cropinghigh/CBModem/hardware/communicator_27mhz.kicad_pcb

## KiCad design hardware/communicator_27mhz.kicad_pcb (2023-03-02)

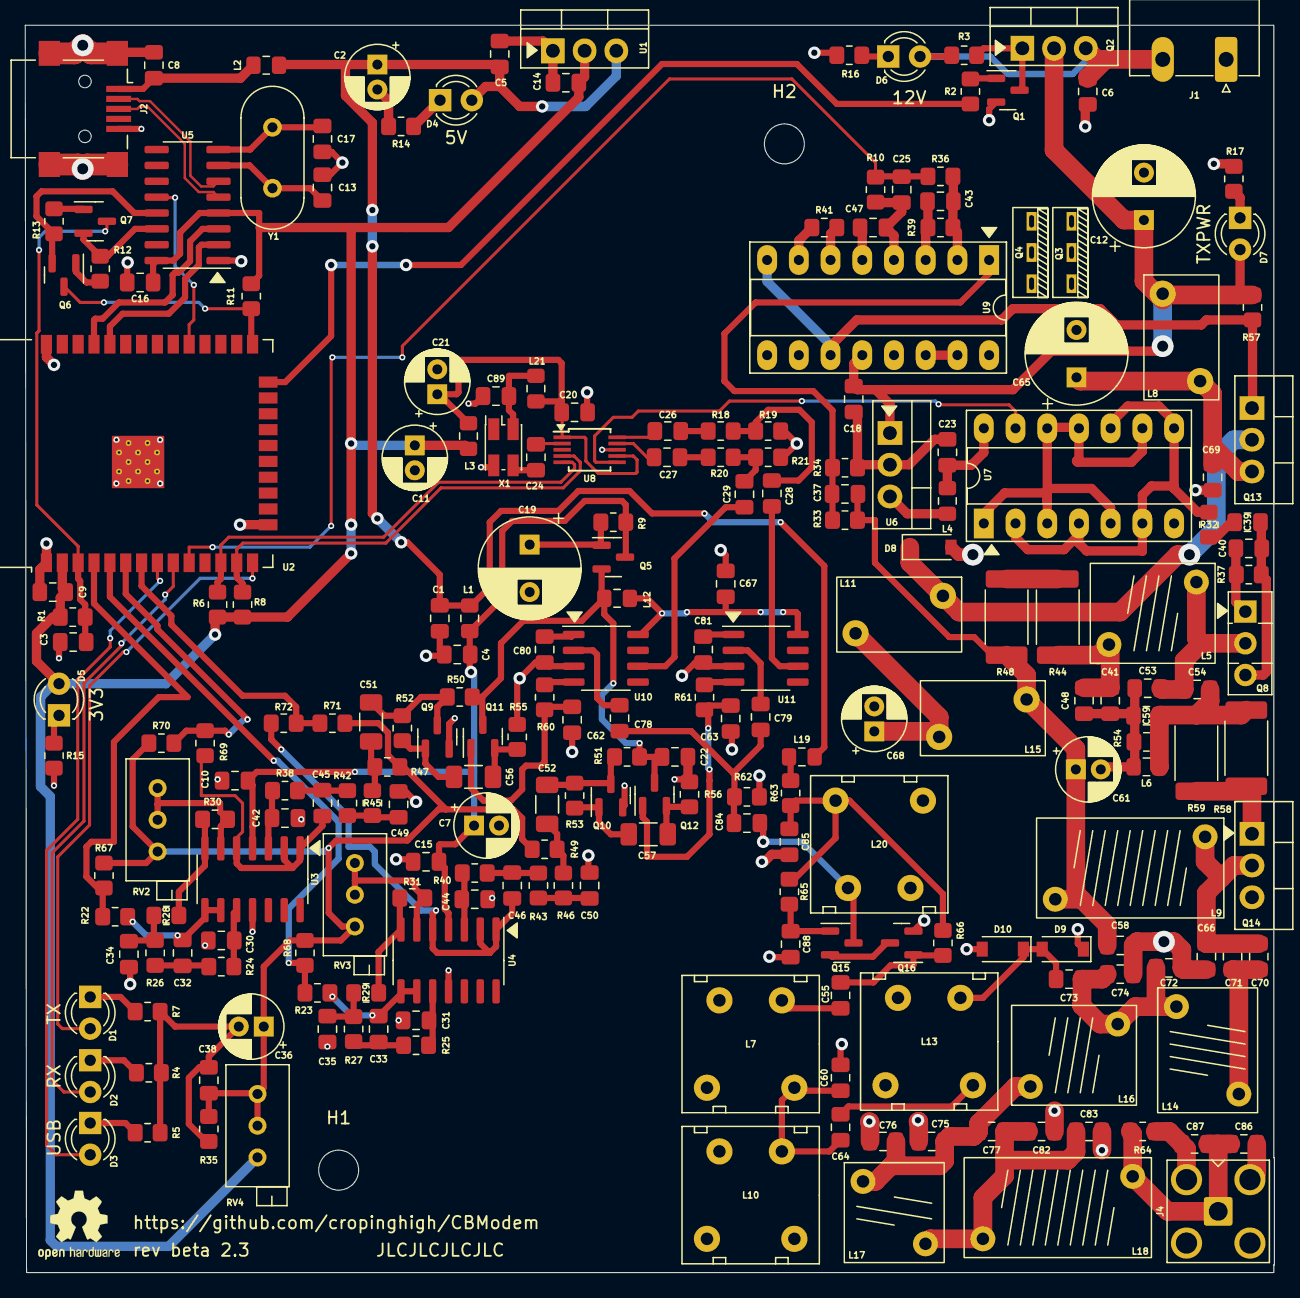
[picture p1: board communicator_27mhz.kicad_pcb from above]

Board: 2 copper layers, 100.0 x 99.9 mm, 230 parts (0 on the bottom side), 132 nets.

Parts:
C1, C4, C5, C6, C8, C9, C10, C14, C15, C16, C18, C20, C23, C24, C26, C27, C28, C29, C38, C39, C43, C54, C58, C67, C69, C85, C89: 0.1u; C_0805_2012Metric_Pad1.18x1.45mm_HandSolder
C3: 2.2u; C_0805_2012Metric_Pad1.18x1.45mm_HandSolder
C7, C21, C36: 47u; CP_Radial_D5.0mm_P2.00mm
C11: 10u; CP_Radial_D5.0mm_P2.00mm
C12, C19: 470u; CP_Radial_D8.0mm_P3.80mm
C13, C17: 22p; C_0805_2012Metric_Pad1.18x1.45mm_HandSolder
C25, C32, C33, C34, C35, C45, C46, C49, C50, C62, C63, C78, C79, C80, C81, C88: 10n; C_0805_2012Metric_Pad1.18x1.45mm_HandSolder
C30, C31, C42, C44, C47: 1n; C_0805_2012Metric_Pad1.18x1.45mm_HandSolder
C37: 6n8; C_0805_2012Metric_Pad1.18x1.45mm_HandSolder
C40, C86: 150p; C_0805_2012Metric_Pad1.18x1.45mm_HandSolder
C41, C48: 47n; C_0805_2012Metric_Pad1.18x1.45mm_HandSolder
C51, C52, C56, C57: 10u; C_1206_3216Metric_Pad1.33x1.80mm_HandSolder
C53, C60, C72, C74, C75: 330p; C_0805_2012Metric_Pad1.18x1.45mm_HandSolder
C55, C64: 470p; C_0805_2012Metric_Pad1.18x1.45mm_HandSolder
C59, C66: 100p; C_0805_2012Metric_Pad1.18x1.45mm_HandSolder
C70, C71, C76, C82, C83: 220p; C_0805_2012Metric_Pad1.18x1.45mm_HandSolder
C73, C84: 47p; C_0805_2012Metric_Pad1.18x1.45mm_HandSolder
C77: 39p; C_0805_2012Metric_Pad1.18x1.45mm_HandSolder
C87: 30p; C_0805_2012Metric_Pad1.18x1.45mm_HandSolder
C?: 22u; CP_Radial_D8.0mm_P3.80mm
C?#2: 47u; CP_Radial_D5.0mm_P2.00mm
C?#3: 0.1u; C_0805_2012Metric_Pad1.18x1.45mm_HandSolder
C?#4, C?#5: 22u; CP_Radial_D5.0mm_P2.00mm
D1: TX; LED_D3.0mm
D2: RX; LED_D3.0mm
D3: USB; LED_D3.0mm
D4: 5V; LED_D3.0mm
D5: 3V3; LED_D3.0mm
D6: 12V; LED_D3.0mm
D7: TXPWR; LED_D3.0mm
D8, D9, D10: 4148; D_SOD-123
H1, H2: M3; MountingHole_3.2mm_M3
J1: EXT_12V; PhoenixContact_MC_1,5_2-G-5.08_1x02_P5.08mm_Horizontal
J2: USB_B_Micro; USB_Mini-B_Lumberg_2486_01_Horizontal
J4: ANT; SMA_Amphenol_901-143_Horizontal
L1, L2, L3, L4, L12, L19, L21: 10uH; L_0805_2012Metric_Pad1.15x1.40mm_HandSolder
L5: 0.15uH(6T,d6); Inductor_10x8
L6: 6.8uH; L_0805_2012Metric_Pad1.15x1.40mm_HandSolder
L7, L10: 220n; Soviet_inductor_core_vertical
L8, L15: ~40T on М2000НМ core; Ferrite_ring_10x6x5_vertical
L9: 0.5uH(13T,d5); Inductor_15x8
L11: 6T on М2000НМ core; Ferrite_ring_10x6x5_vertical
L13: 820n; Soviet_inductor_core_vertical
L14: 0.225uH(6T,d6); Inductor_10x8
L16: 6T, d=5; Inductor_10x8
L17: 7T, d=4; Inductor_8x8
L18: 10T, d=4mm; Inductor_15x8
L20: 3.7-20uH; Soviet_inductor_core_vertical
LOGO1: Logo_Open_Hardware_Large; OSHW-Logo2_7.3x6mm_SilkScreen
Q1: MMBT2222A; SOT-23
Q2, Q13: IRF9Z34N; TO-220-3_Vertical
Q3, Q4: KT315; KT-13
Q8: C2314; TO-126-3_Vertical
Q14: C2078; TO-220-3_Vertical
Q?: MMBT2222A; SOT-23
Q?#2, Q?#3, Q?#4, Q?#5, Q?#6, Q?#7, Q?#8, Q?#9: MMBT2222A; SOT-23
R1, R3, R11, R12, R13, R22, R23, R26, R27, R42, R43, R67, R68, R69, R70, R71, R72: 10k; R_0805_2012Metric_Pad1.20x1.40mm_HandSolder
R2: 50k; R_0805_2012Metric_Pad1.20x1.40mm_HandSolder
R4, R5, R6, R7, R8, R15: 1k; R_0805_2012Metric_Pad1.20x1.40mm_HandSolder
R9, R62: 680; R_0805_2012Metric_Pad1.20x1.40mm_HandSolder
R14: 2k; R_0805_2012Metric_Pad1.20x1.40mm_HandSolder
R16, R17, R34, R41, R47, R49, R50, R51: 5k; R_0805_2012Metric_Pad1.20x1.40mm_HandSolder
R18, R20: 6k8; R_0805_2012Metric_Pad1.20x1.40mm_HandSolder
R19, R21: 510; R_0805_2012Metric_Pad1.20x1.40mm_HandSolder
R24, R25, R38, R40: 5k6; R_0805_2012Metric_Pad1.20x1.40mm_HandSolder
R28, R29, R45, R46, R60, R61: 3k3; R_0805_2012Metric_Pad1.20x1.40mm_HandSolder
R30, R31: 20k; R_0805_2012Metric_Pad1.20x1.40mm_HandSolder
R32: 10; R_0805_2012Metric_Pad1.20x1.40mm_HandSolder
R35: 500; R_0805_2012Metric_Pad1.20x1.40mm_HandSolder
R36: 470; R_0805_2012Metric_Pad1.20x1.40mm_HandSolder
R37, R63: 100; R_0805_2012Metric_Pad1.20x1.40mm_HandSolder
R39, R52, R53: 100k; R_0805_2012Metric_Pad1.20x1.40mm_HandSolder
R44, R48, R58, R59: 5 1W; R_2512_6332Metric_Pad1.40x3.35mm_HandSolder
R54: 150; R_0805_2012Metric_Pad1.20x1.40mm_HandSolder
R55, R56: 900; R_0805_2012Metric_Pad1.20x1.40mm_HandSolder
R57: 330; R_0805_2012Metric_Pad1.20x1.40mm_HandSolder
R64: 4k7; R_0805_2012Metric_Pad1.20x1.40mm_HandSolder
R65, R66: 25k; R_0805_2012Metric_Pad1.20x1.40mm_HandSolder
R?: 20k; R_0805_2012Metric_Pad1.20x1.40mm_HandSolder
R?#2: 20k; R_0805_2012Metric_Pad1.20x1.40mm_HandSolder
RV2, RV3: 10k; Potentiometer_Bourns_3296X_Horizontal
RV?: 100k; Potentiometer_Bourns_3296X_Horizontal
U1: LM1117-3.3; TO-220-3_Vertical
U2: ESP32-WROOM-32
U3, U4: LM324; SOIC-14_3.9x8.7mm_P1.27mm
U5: CH340G; SOIC-16_3.9x9.9mm_P1.27mm
U6: L7805; TO-220-3_Vertical
U7: 74ACT14; DIP-14_W7.62mm_Socket_LongPads
U8: Si5351A; MSOP-10_3x3mm_P0.5mm
U9: TL494; DIP-16_W7.62mm_Socket_LongPads
U10, U11: SA612; SO-8_3.9x4.9mm_P1.27mm
X1: 3225 25 MHz TCXO; Oscillator_SMD_EuroQuartz_XO32-4Pin_3.2x2.5mm_HandSoldering
Y1: 12M; Crystal_HC49-4H_Vertical

Connections:
+3V3: C9.1, C11.1, C14.1, C16.2, D5.2 (A), L3.1, R1.1, R6.2, R8.2, R11.2, RV?.3, U1.2 (VO), U2.2 (VDD), U5.4 (V3), U5.16 (VCC)
+3V3FILT: C20.2, C21.1, L3.2, L21.2, U8.1 (VDD), U8.7 (VDDO)
+5V: C1.1, C5.1, C?#2.1, D4.2 (A), L1.1, L2.2, L19.2, U1.3 (VI)
+5VFILT: C4.1, C7.1, C10.1, C15.1, L1.2, Q?#3.3 (C), R9.1, U3.4 (V+), U4.4 (V+)
+5VMXR: C?#3.2, L12.1, Q?.3 (C), Q?#3.2 (E), Q?#8.3 (C), R50.1, R51.1
+5VTX: L4.1, U6.3 (OUT)
+12V: C6.1, D6.2 (A), J1.2, Q2.3 (S), R3.1
+12VTX: C12.1, C18.1, D7.2 (A), L8.2, Q2.2 (D), R57.1, U6.1 (IN), U9.12 (VCC)
/CLK_I: C27.1, U8.9 (CLK1)
/CLK_Q: C26.1, U8.10 (CLK0)
/RX_ANT_CLAMPED: C73.2, D9.2 (A), D10.1 (K), L13.2
/SCL: R8.1, U2.13 (IO14), U8.4 (SCL)
/SDA: R6.1, U2.12 (IO27), U8.5 (SDA)
/UD+: J2.3 (D+), U5.5 (UD+)
/UD-: J2.2 (D-), U5.6 (UD-)
ADCIN_I: R22.1, R67.2, U2.4 (SENSOR_VP)
ADCIN_LOW_I: R69.1, R70.2, U2.6 (IO34)
ADCIN_LOW_Q: R71.1, R72.2, U2.7 (IO35)
ADCIN_Q: R23.1, R68.1, U2.5 (SENSOR_VN)
GND: C1.2, C3.2, C4.2, C5.2, C6.2, C7.2, C8.2, C9.2, C10.2, C11.2, C12.2, C13.2, C14.2, C15.2, C16.1, C17.2, C18.2, C19.2, C20.1, C21.2, C23.2, C25.2, C30.2, C31.2, C34.2, C35.2, C36.2, C38.2, C40.1, C41.2, C42.2, C44.2, C47.1, C48.2, C49.2, C50.2, C53.2, C58.2, C59.2, C60.2, C62.2, C63.2, C66.2, C67.2, C69.2, C72.2, C74.2, C75.2, C76.2, C80.2, C81.2, C82.2, C83.2, C85.2, C86.2, C87.2, C88.1, C89.2, C?.2, C?#2.2, C?#3.1, C?#4.2, C?#5.2, D8.2 (A), D9.1 (K), D10.2 (A), J1.1, J2.5 (GND), J2.6 (Shield), J4.2 (Ext), L6.2, L10.1, Q1.2 (E), Q3.1 (B), Q3.2 (C), Q3.3 (E), Q4.1 (B), Q4.2 (C), Q4.3 (E), Q8.1 (E), Q14.3 (E), Q?#4.2 (E), Q?#6.2 (E), Q?#9.2 (E), R4.2, R5.1, R7.2, R14.2, R15.2, R16.2, R17.2, R19.1, R21.1, R34.2, R35.2, R37.2, R41.2, R54.2, R55.2, R56.2, R62.2, R64.2, R?.1, U1.1 (GND), U2.1 (GND), U2.15 (GND), U2.38 (GND), U2.39 (GND), U3.11 (V-), U4.11 (V-), U5.1 (GND), U6.2 (GND), U7.7 (GND), U8.8 (GND), U9.4 (DTC), U9.7 (GND), U9.9 (E1), U9.10 (E2), U9.13 (OUTCTRL), U9.16 (2IN+), U10.3 (GND), U11.3 (GND), X1.2 (GND)
LO_RX_I: C29.2, U10.6 (OSC_B)
LO_RX_Q: C28.1, U11.6 (OSC_B)
LO_TX: U7.13, U8.6 (CLK2)
MCU_DCD: U2.29 (IO5), U5.12 (~DCD)
MCU_EN: C3.1, Q?#7.3 (C), R1.2, U2.3 (EN)
MCU_G0: Q?#2.3 (C), R11.1, U2.25 (IO0)
MCU_RXD: U2.34 (RXD0/IO3), U5.2 (TXD)
MCU_TXD: U2.35 (TXD0/IO1), U5.3 (RXD)
unnamed: C8.1, J2.1 (VBUS), L2.1
unnamed: C13.1, U5.7 (XI), Y1.1
unnamed: C17.1, U5.8 (XO), Y1.2
unnamed: C19.1, Q?#3.1 (B), R9.2
unnamed: C23.1, L4.2, U7.14 (VCC)
unnamed: C24.1, X1.3 (OUT)
unnamed: C24.2, U8.2 (XA)
unnamed: C26.2, R18.2
unnamed: C27.2, R20.2
unnamed: C28.2, R18.1, R19.2
unnamed: C29.1, R20.1, R21.2
unnamed: C30.1, R24.2, U3.10 (+)
unnamed: C31.1, R25.2, U4.10 (+)
unnamed: C32.1, R24.1, R26.2
unnamed: C32.2, R22.2, U3.8, U3.9 (-)
unnamed: C33.1, R25.1, R27.2
unnamed: C33.2, R23.2, U4.8, U4.9 (-)
unnamed: C34.1, R26.1, R28.2
unnamed: C35.1, R27.1, R29.2
unnamed: C37.1, C58.1, C?#4.1, L9.1, L15.2, R48.2, R?#2.1
unnamed: C37.2, R34.1, R?#2.2, U9.1 (1IN+)
unnamed: C39.1, R32.2
unnamed: C39.2, C40.2, Q8.3 (B), R37.1
unnamed: C41.1, C48.1, L5.1, R44.1
unnamed: C42.1, R38.2, U3.3 (+)
unnamed: C43.1, R36.2, R39.2, U9.2 (1IN-)
unnamed: C43.2, R39.1, U9.3 (FB)
unnamed: C44.1, R40.2, U4.3 (+)
unnamed: C45.1, R38.1, R42.2
unnamed: C45.2, R69.2, U3.1, U3.2 (-), U3.5 (+)
unnamed: C46.1, R40.1, R43.2
unnamed: C46.2, R72.1, U4.1, U4.2 (-), U4.5 (+)
unnamed: C47.2, U9.5 (CT)
unnamed: C49.1, R42.1, R45.2
unnamed: C50.1, R43.1, R46.2
unnamed: C51.1, Q?#6.3 (C), R50.2, R52.1
unnamed: C51.2, R45.1, R47.1
unnamed: C52.1, Q?#4.3 (C), R51.2, R53.1
unnamed: C52.2, R46.1, R49.1
unnamed: C53.1, C54.2, L5.2, Q8.2 (C)
unnamed: C54.1, C59.1, L6.1, R54.1, R58.2, R59.1
unnamed: C55.2, L7.2
unnamed: C56.1, Q?.2 (E), R55.1
unnamed: C56.2, Q?#6.1 (B), R52.2
unnamed: C57.1, Q?#8.2 (E), R56.1
unnamed: C57.2, Q?#4.1 (B), R53.2
unnamed: C60.1, C64.1, L7.1, L10.2
unnamed: C62.1, Q?.1 (B), R60.2
unnamed: C63.1, Q?#8.1 (B), R61.2
unnamed: C64.2, L13.1
unnamed: C69.1, C?.1, L8.1, Q13.3 (S)
unnamed: C66.1, C70.2, C71.2, L9.2, Q14.2 (C)
unnamed: C67.1, L12.2, U10.8 (VCC), U11.8 (VCC)
unnamed: C?#5.1, L11.1, L15.1
unnamed: C70.1, C71.1, L14.1
unnamed: C72.1, C73.1, C74.1, L14.2, L16.1
unnamed: C75.1, C76.1, C77.1, L16.2, L17.2
unnamed: C77.2, C82.1, C83.1, L17.1, L18.1
unnamed: C78.1, C79.1, C84.2, R62.1
unnamed: C78.2, U10.2 (IN_B)
unnamed: C79.2, U11.2 (IN_B)
unnamed: C80.1, U10.1 (IN_A)
unnamed: C81.1, U11.1 (IN_A)
unnamed: C84.1, L20.2, Q?#5.3 (C)
unnamed: C85.1, L20.1, R63.2, R65.1, R66.1
unnamed: C86.1, C87.1, J4.1 (In), L18.2, R64.1
unnamed: C88.2, Q?#5.1 (B), R65.2
unnamed: C89.1, L21.1, X1.4 (Vcc)
unnamed: D1.1 (K), R7.1
unnamed: D1.2 (A), U2.14 (IO12)
unnamed: D2.1 (K), R4.1
unnamed: D2.2 (A), U2.9 (IO33)
unnamed: D3.1 (K), R5.2
unnamed: D3.2 (A), U2.8 (IO32)
unnamed: D4.1 (K), R14.1
unnamed: D5.1 (K), R15.1
unnamed: D6.1 (K), R16.1
unnamed: D7.1 (K), R17.1
unnamed: D8.1 (K), L11.2, Q13.2 (D)
unnamed: L19.1, R63.1
unnamed: Q1.1 (B), R2.1
unnamed: Q1.3 (C), Q2.1 (G), R3.2
unnamed: Q?#2.1 (B), R12.2
unnamed: Q?#2.2 (E), R13.1, U5.13 (~DTR)
unnamed: Q?#7.1 (B), R13.2
unnamed: Q?#7.2 (E), R12.1, U5.14 (~RTS)
unnamed: Q13.1 (G), R57.2, U9.8 (C1), U9.11 (C2)
unnamed: Q14.1 (B), R58.1, R59.2
unnamed: Q?#5.2 (E), Q?#9.3 (C)
unnamed: R28.1, R30.1, U3.7
unnamed: R29.1, R31.1, U4.7
unnamed: R30.2, RV2.1, RV2.2, U3.6 (-)
unnamed: R31.2, RV3.1, RV3.2, U4.6 (-)
unnamed: R32.1, U7.2, U7.4, U7.6, U7.8, U7.10
unnamed: R41.1, U9.6 (RT)
unnamed: R44.2, R48.1
unnamed: R60.1, U10.4 (OUT_A)
unnamed: R61.1, U11.4 (OUT_A)
unnamed: U7.1, U7.3, U7.5, U7.9, U7.11, U7.12
unnamed: U9.14 (REF), U9.15 (2IN-)
RX_AMP_REF_V: C36.1, C38.1, R35.1, R47.2, R49.2, R67.1, R68.2, R70.1, R71.2, RV2.3, RV3.3, RV?.1, RV?.2
RX_IN_ANT: C55.1, Q?#9.1 (B), R66.2
TXAMPL_V: C25.1, R36.1, R?.2, U2.10 (IO25)
TXPENABLE: R2.2, U2.24 (IO2)
