cropinghigh/CBModem/software/esp32/app/components/customdsp/srcs/cdsp_modulator.cpp

#include "cdsp_modulator.h" 

#include "stdio.h"

cdsp_mod_bfsk::cdsp_mod_bfsk(float fs, float fr0, float fr1, float datarate, int taps_cnt) {
    _taps_cnt = taps_cnt;
    _gen = new cdsp_gen_sine_complex(fs, fr0);
    setFs(fs);
    setFrs(fr0, fr1);
    setDataRate(datarate);
    _filt_taps = new float[_taps_cnt];
    float maxfreq = std::max(fabsf(fr0), fabsf(fr1)) + datarate;
    cdsp_calc_taps_lpf_float(_filt_taps, _taps_cnt, fs, maxfreq, true);
    _filt = new cdsp_fir<float, cdsp_complex_t>(_taps_cnt, _filt_taps);
    _filt->setInputFunc(this, filt_requestData);
}

cdsp_mod_bfsk::~cdsp_mod_bfsk() {
    delete[] _filt_taps;
    delete _filt;
    delete _gen;
}

void cdsp_mod_bfsk::setFs(float fs) {
    _fs = fs;
    _gen->setFs(_fs);
    if(_fs != 0) {
        _incr = _datarate / _fs;
        // printf("dr %f fs %f incr %f\n", _datarate, _fs, _incr);
    }
}

void cdsp_mod_bfsk::setFrs(float fr0, float fr1) {
    _fr0 = fr0;
    _fr1 = fr1;
}

void cdsp_mod_bfsk::setDataRate(float datarate) {
    _datarate = datarate;
    if(_fs != 0) {
        setFs(_fs);
    }
}

int cdsp_mod_bfsk::requestData(void* ctx, cdsp_complex_t* data, int samples_cnt) {
    cdsp_mod_bfsk* _this = (cdsp_mod_bfsk*) ctx;
    if(!_this->_running) {return -2;}
    // return _this->_filt->requestData(_this->_filt, data, samples_cnt); Works better without FIR
    return _this->filt_requestData(_this, data, samples_cnt);
}

int cdsp_mod_bfsk::filt_requestData(void* ctx, cdsp_complex_t* data, int samples_cnt) {
    cdsp_mod_bfsk* _this = (cdsp_mod_bfsk*) ctx;
    if(!_this->_running || _this->_input_func==NULL || _this->_incr <= 0) { return -2;}
    int ret = 0;
    while(ret < samples_cnt) {
        int remaining_spls = std::min((int)roundf((1.0f / _this->_incr) * (1.0f - _this->_ctr)), samples_cnt-ret);
        // printf("remain %f, want %d, ctr %f, req %d\n", floorf((1.0f / _this->_incr) * (1.0f - _this->_ctr)), samples_cnt-ret, _this->_ctr, remaining_spls);
        int gotmain = _this->_gen->requestData(_this->_gen, &data[ret], remaining_spls);
        if(gotmain <= 0) {return gotmain;}
        ret += gotmain;
        _this->_ctr += gotmain * _this->_incr;
        if(_this->_ctr >= 1.0f || ((1.0f / _this->_incr) * (1.0f - _this->_ctr)) < 1) {
            // printf("%d %d %d %d %f %f\n", remaining_spls, gotmain, samples_cnt, ret, _this->_incr, _this->_ctr);
            if(_this->_preamble_ctr < MOD_PREAMBLE_SIZE) {
                _this->_gen->setFr((_this->_preamble_ctr % 2) ? _this->_fr1 : _this->_fr0);
                _this->_preamble_ctr++;
            } else {
                int got = _this->_input_func(_this->_func_call_ctx, &_this->_curr_data, 1);
                if(got != 1) {return got;}
                if(_this->_curr_data) {
                    _this->_gen->setFr(_this->_fr1);
                } else {
                    _this->_gen->setFr(_this->_fr0);
                }
            }
            _this->_ctr = 0.0f;
        }
    }
    return ret;
}

void cdsp_mod_bfsk::_do_start()  {
    _ctr = 0;
    _preamble_ctr = 0;
    _gen->start(true);
    _filt->start(true);
}

void cdsp_mod_bfsk::_do_stop() {
    _gen->stop(true);
    _filt->stop(true);
}


cdsp_mod_mfsk::cdsp_mod_mfsk(float fs, int frcnt, float* frs, float datarate, int taps_cnt) {
    _taps_cnt = taps_cnt;
    _frcnt = frcnt;
    _gen = new cdsp_gen_sine_complex(fs, frs[0]);
    setFs(fs);
    setFrs(_frcnt, frs);
    setDataRate(datarate);
    _filt_taps = new float[_taps_cnt];
    float maxfr = -100000;
    for(int i = 0; i < frcnt; i++) {
        maxfr = std::max(maxfr, frs[i]);
    }
    float maxfreq = maxfr + datarate;
    cdsp_calc_taps_lpf_float(_filt_taps, _taps_cnt, fs, maxfreq, true);
    _filt = new cdsp_fir<float, cdsp_complex_t>(_taps_cnt, _filt_taps);
    _filt->setInputFunc(this, filt_requestData);
}

cdsp_mod_mfsk::~cdsp_mod_mfsk() {
    delete[] _filt_taps;
    delete[] _frs;
    delete _filt;
    delete _gen;
}

void cdsp_mod_mfsk::setFs(float fs) {
    _fs = fs;
    _gen->setFs(_fs);
    if(_fs != 0) {
        _incr = _datarate / _fs;
    }
}

void cdsp_mod_mfsk::setFrs(int frcnt, float* frs) {
    _frcnt = frcnt;
    _frbits = floorf(log2f(frcnt));
    assert(_frbits < 256 && _frbits >= 1);
    if(_frs != NULL) {
        delete[] _frs;
    }
    _frs = new float[_frcnt];
    for(int i = 0; i < _frcnt; i++) {
        _frs[i] = frs[i];
    }
}

void cdsp_mod_mfsk::setDataRate(float datarate) {
    _datarate = datarate;
    if(_fs != 0) {
        _incr = _datarate / _fs;
    }
}

int cdsp_mod_mfsk::requestData(void* ctx, cdsp_complex_t* data, int samples_cnt) {
    cdsp_mod_mfsk* _this = (cdsp_mod_mfsk*) ctx;
    if(!_this->_running) {return -2;}
    // return _this->_filt->requestData(_this->_filt, data, samples_cnt); Works much better without FIR
    return _this->filt_requestData(_this, data, samples_cnt);
}

int cdsp_mod_mfsk::filt_requestData(void* ctx, cdsp_complex_t* data, int samples_cnt) {
    cdsp_mod_mfsk* _this = (cdsp_mod_mfsk*) ctx;
    if(!_this->_running || _this->_input_func==NULL || _this->_incr <= 0) { return -2;}
    int ret = 0;
    while(ret < samples_cnt) {
        int remaining_spls = std::min((int)roundf((1.0f / _this->_incr) * (1.0f - _this->_ctr)), samples_cnt-ret);
        int gotmain = _this->_gen->requestData(_this->_gen, &data[ret], remaining_spls);
        if(gotmain <= 0) {return gotmain;}
        ret += gotmain;
        _this->_ctr += gotmain * _this->_incr;
        if(_this->_ctr >= 1.0f || ((1.0f / _this->_incr) * (1.0f - _this->_ctr)) < 1) {
            if(_this->_preamble_ctr < MOD_PREAMBLE_SIZE) {
                _this->_gen->setFr((_this->_preamble_ctr % 2) ? _this->_frs[_this->_frcnt-1] : _this->_frs[0]);
                _this->_preamble_ctr++;
            } else {
                int got = _this->_input_func(_this->_func_call_ctx, _this->_curr_data, _this->_frbits);
                if(got <= 0) {return got;}
                uint8_t newfr = 0;
                for(int i = 0; i < got; i++) {
                    newfr |= ((_this->_curr_data[i] & 0b1) << i);
                }
                _this->_gen->setFr(_this->_frs[newfr]);
            }
            _this->_ctr = 0.0f;
        }
    }
    return ret;
}

void cdsp_mod_mfsk::_do_start() {
    _ctr = 0;
    _preamble_ctr = 0;
    _gen->start(true);
    _filt->start(true);
}

void cdsp_mod_mfsk::_do_stop() {
    _gen->stop(true);
    _filt->stop(true);
}

cdsp_mod_msk::cdsp_mod_msk(float fs, float datarate) {
    _gen = new cdsp_gen_sine_complex(fs, datarate/4.0f);
    setFs(fs);
    setDataRate(datarate);
}

cdsp_mod_msk::~cdsp_mod_msk() {
    delete _gen;
}

void cdsp_mod_msk::setFs(float fs) {
    _fs = fs;
    _gen->setFs(_fs);
    if(_fs != 0) {
        _incr = _datarate / _fs;
        // printf("dr %f fs %f incr %f\n", _datarate, _fs, _incr);
    }
}

void cdsp_mod_msk::setDataRate(float datarate) {
    _datarate = datarate;
    if(_fs != 0) {
        setFs(_fs);
    }
}

float cdsp_mod_msk::getDataRate() {
    return _datarate;
}

int cdsp_mod_msk::requestData(void* ctx, cdsp_complex_t* data, int samples_cnt) {
    cdsp_mod_msk* _this = (cdsp_mod_msk*) ctx;
    if(!_this->_running || _this->_input_func==NULL || _this->_incr <= 0) { return -2;}
    int ret = 0;
    while(ret < samples_cnt) {
        int remaining_spls = std::min((int)roundf((1.0f / _this->_incr) * (1.0f - _this->_ctr)), samples_cnt-ret);
        int gotmain = _this->_gen->requestData(_this->_gen, &data[ret], remaining_spls);
        if(gotmain <= 0) {return gotmain;}
        ret += gotmain;
        _this->_ctr += gotmain * _this->_incr;
        if(_this->_ctr >= 1.0f || ((1.0f / _this->_incr) * (1.0f - _this->_ctr)) < 1) {
            if(_this->_preamble_ctr < MOD_PREAMBLE_SIZE) {
                _this->_gen->setFr((_this->_preamble_ctr % 2) ? (_this->_datarate/4.0f) : (-_this->_datarate/4.0f));
                _this->_preamble_ctr++;
            } else {
                int got = _this->_input_func(_this->_func_call_ctx, &_this->_curr_data, 1);
                if(got != 1) {return got;}
                if(_this->_curr_data) {
                    _this->_gen->setFr((_this->_datarate/4.0f));
                } else {
                    _this->_gen->setFr((-_this->_datarate/4.0f));
                }
            }
            _this->_ctr = 0.0f;
        }
    }
    return ret;
}

void cdsp_mod_msk::_do_start() {
    _ctr = 0;
    _preamble_ctr = 0;
    _gen->start(true);
}

void cdsp_mod_msk::_do_stop() {
    _gen->stop(true);
}


cdsp_demod_bfsk::cdsp_demod_bfsk(float fs, float fr0, float fr1, float datarate, float sync_loop_bw, float sync_damping, float sync_relLimit) {
    setFs(fs);
    setFrs(fr0, fr1);
    setDataRate(datarate);
    _filt = new cdsp_fir<float, float>(_taps_cnt, _filt_taps);
    _sync = new cdsp_maximum_likelihood_tr<float>(_incr, sync_loop_bw, sync_damping, sync_relLimit);
    _dcblock = new cdsp_dcblock<float>(1.0f);
    _infilt = new cdsp_fir<float, cdsp_complex_t>(_infilt_taps_cnt, _infilt_taps);
    _sync->setInputBlk(_dcblock, _dcblock->requestData);
    _dcblock->setInputBlk(_filt, _filt->requestData);
    _filt->setInputFunc(this, dcb_requestData);
    _infilt->setInputFunc(this, infilt_requestData);
}

cdsp_demod_bfsk::~cdsp_demod_bfsk() {
    delete _filt;
    delete _dcblock;
    delete _sync;
    delete _infilt;
    delete[] _filt_taps;
    delete[] _infilt_taps;
}

void cdsp_demod_bfsk::setFs(float fs) {
    _fs = fs;
    if(_datarate != 0) {
        _incr = _fs / (_datarate);
        _taps_cnt = (int(roundf(_incr)) % 2) ? roundf(_incr)+1 : roundf(_incr);
        _infilt_taps_cnt = _taps_cnt;
        if(_filt_taps != NULL) {
            delete[] _filt_taps;
        }
        if(_infilt_taps != NULL) {
            delete[] _infilt_taps;
        }
        _filt_taps = new float[_taps_cnt];
        _infilt_taps = new float[_infilt_taps_cnt];
        cdsp_calc_taps_lpf_float(_filt_taps, _taps_cnt, _fs, _datarate*1.0f, true);
        cdsp_calc_taps_lpf_float(_infilt_taps, _infilt_taps_cnt, _fs, (fabsf(_fr0) >= fabsf(_fr1) ? 2*fabsf(_fr0*_fs) : 2*fabsf(_fr1*_fs)) + _datarate, true);
        if(_filt != NULL) {
            _filt->setTaps(_taps_cnt, _filt_taps);
        }
        if(_infilt != NULL) {
            _infilt->setTaps(_infilt_taps_cnt, _infilt_taps);
        }
        if(_sync != NULL) {
            _sync->setInSps(_incr);
        }
    }
}

void cdsp_demod_bfsk::setFrs(float fr0, float fr1) {
    _fr0 = fr0 / _fs;
    _fr1 = fr1 / _fs;
    float high = std::max(fabsf(_fr0), fabsf(_fr1));
    _syncmul = 1.0f/high;
    _syncdiv = high;
    if(_datarate != 0) {
        setFs(_fs);
    }
}

void cdsp_demod_bfsk::setDataRate(float datarate) {
    _datarate = datarate;
    if(_datarate != 0) {
        setFs(_fs);
    }
}

void cdsp_demod_bfsk::setLoopBw(float bw) {
	_sync->setLoopBw(bw);
}

//int x = 0;

int cdsp_demod_bfsk::requestData(void* ctx, uint8_t* data, int samples_cnt) {
    cdsp_demod_bfsk* _this = (cdsp_demod_bfsk*) ctx;
    if(!_this->_running || _this->_incr <= 0) { return -2;}
    int req_samples = std::min(samples_cnt, CDSP_DEF_BUFF_SIZE);
    int got = _this->_sync->requestData(_this->_sync, _this->_out_samples, req_samples);
    if(got <= 0) { return got; }
    for(int i = 0; i < got; i++) {
        float curr_fr = _this->_out_samples[i]*_this->_syncdiv;
        float err0 = _this->_fr0 - curr_fr;
        float err1 = _this->_fr1 - curr_fr;
        float nearerr = fabsf(err1) < fabsf(err0) ? err1 : err0;
        data[i] = fabsf(err1) < fabsf(err0) ? 1 : 0; //Binary slicer
        _this->_avgerr += (nearerr - _this->_avgerr) * 0.05f;
//        x += _this->_incr;
    }
    return got;
}

int cdsp_demod_bfsk::dcb_requestData(void* ctx, float* data, int samples_cnt) {
    cdsp_demod_bfsk* _this = (cdsp_demod_bfsk*) ctx;
    if(!_this->_running || _this->_input_func==NULL || _this->_incr <= 0) {return -2;}
    int req_samples = std::min(samples_cnt, CDSP_DEF_BUFF_SIZE);
//     int got = _this->_input_func(_this->_func_call_ctx, _this->_in_samples, req_samples);
    int got = _this->_infilt->requestData(_this->_infilt, _this->_in_samples, req_samples);
    if(got <= 0) {return got;}
    for(int i = 0; i < got; i++) {
        // printf("%d %f %f\n", x, _this->_in_samples[i].i, _this->_in_samples[i].q);
        // x++;
        float fr_rel = (_this->_in_samples[i]*_this->_prev_spl.conj()).ph() * (1.0f/(2.0f*FL_PI)); //Interesting f/fs detector, stolen from gnuradio quadrature demod; works SIGNIFICANTLY better than coherent multiplication&filtering
        _this->_prev_spl = _this->_in_samples[i];
        float err0 = _this->_fr0 - fr_rel;
        float err1 = _this->_fr1 - fr_rel;
        float nearerr = fabsf(err1) < fabsf(err0) ? 0 : err0;
        data[i] = fr_rel * _this->_syncmul;
    }
    return got;
}

int cdsp_demod_bfsk::infilt_requestData(void* ctx, cdsp_complex_t* data, int samples_cnt) {
    cdsp_demod_bfsk* _this = (cdsp_demod_bfsk*) ctx;
    if(!_this->_running || _this->_input_func==NULL || _this->_incr <= 0) {return -2;}
    return _this->_input_func(_this->_func_call_ctx, data, samples_cnt);
}

void cdsp_demod_bfsk::_do_start() {
    _avgerr = 0;
    _infilt->start(true);
    _sync->start(true);
}

void cdsp_demod_bfsk::_do_stop() {
    _infilt->stop(true);
    _sync->stop(true);
}


cdsp_demod_mfsk::cdsp_demod_mfsk(float fs, int frcnt, float* frs, float datarate, float sync_loop_bw, float sync_damping, float sync_relLimit) {
    setFs(fs);
    setFrs(frcnt, frs);
    setDataRate(datarate);
    _filt = new cdsp_fir<float, float>(_taps_cnt, _filt_taps);
    _sync = new cdsp_maximum_likelihood_tr<float>(_incr, sync_loop_bw, sync_damping, sync_relLimit);
    _dcblock = new cdsp_dcblock<float>(1.0f);
    _infilt = new cdsp_fir<float, cdsp_complex_t>(_infilt_taps_cnt, _infilt_taps);
    _sync->setInputBlk(_dcblock, _dcblock->requestData);
    _dcblock->setInputBlk(_filt, _filt->requestData);
    _filt->setInputFunc(this, dcb_requestData);
    _infilt->setInputFunc(this, infilt_requestData);
}

cdsp_demod_mfsk::~cdsp_demod_mfsk() {
    delete[] _frs;
    delete _dcblock;
    delete _sync;
    delete _filt;
    delete _infilt;
    delete[] _filt_taps;
    delete[] _infilt_taps;
}

void cdsp_demod_mfsk::setFs(float fs) {
    _fs = fs;
    if(_datarate != 0) {
        _incr = _fs / (_datarate);
        _taps_cnt = (int(roundf(_incr)) % 2) ? roundf(_incr)+1 : roundf(_incr);
        _infilt_taps_cnt = _taps_cnt;
        if(_filt_taps != NULL) {
            delete[] _filt_taps;
        }
        if(_infilt_taps != NULL) {
            delete[] _infilt_taps;
        }
        _filt_taps = new float[_taps_cnt];
        _infilt_taps = new float[_infilt_taps_cnt];
        cdsp_calc_taps_lpf_float(_filt_taps, _taps_cnt, _fs, _datarate, true);
        float maxfr = fabsf(_frs[0]);
        for(int i = 0; i < _frcnt; i++) {
            if(fabsf(_frs[i]) > maxfr) {
                maxfr = fabsf(_frs[i]);
            }
        }
        cdsp_calc_taps_lpf_float(_infilt_taps, _infilt_taps_cnt, _fs, 2*maxfr*_fs + _datarate, true);
        if(_filt != NULL) {
            _filt->setTaps(_taps_cnt, _filt_taps);
        }
        if(_infilt != NULL) {
            _infilt->setTaps(_infilt_taps_cnt, _infilt_taps);
        }
        if(_sync != NULL) {
            _sync->setInSps(_incr);
        }
    }
}

void cdsp_demod_mfsk::setFrs(int frcnt, float* frs) {
    _frcnt = frcnt;
    _frbits = floorf(log2f(frcnt));
    assert(_frbits < 256 && _frbits >= 1);
    if(_frs != NULL) {
        delete[] _frs;
    }
    _frs = new float[_frcnt];
    float high = 0.0f;
    for(int i = 0; i < _frcnt; i++) {
        _frs[i] = frs[i] / _fs;
        if(fabsf(_frs[i]) > high) {
            high = fabsf(_frs[i]);
        }
    }
    _syncmul = 1.0f/high;
    _syncdiv = high;
    if(_datarate != 0) {
        setFs(_fs);
    }
}

void cdsp_demod_mfsk::setDataRate(float datarate) {
    _datarate = datarate;
    if(_datarate != 0) {
        setFs(_fs);
    }
}

void cdsp_demod_mfsk::setLoopBw(float bw) {
	_sync->setLoopBw(bw);
}

//int x = 0;
//int y = 0;

int cdsp_demod_mfsk::requestData(void* ctx, uint8_t* data, int samples_cnt) {
    cdsp_demod_mfsk* _this = (cdsp_demod_mfsk*) ctx;
    if(!_this->_running || _this->_incr <= 0) { return -2;}
    int req_samples = std::min(samples_cnt, CDSP_DEF_BUFF_SIZE);
    int got_samples = 0;
    while(got_samples < req_samples) {
        if(_this->_outbuff_data > 0) {
            data[got_samples] = (_this->_outbuff[_this->_outbuff_ptr] & (1 << _this->_outbuff_bit)) >> _this->_outbuff_bit;
            got_samples++;
            _this->_outbuff_bit++;
            if(_this->_outbuff_bit >= _this->_frbits) {
                _this->_outbuff_bit = 0;
                _this->_outbuff_data--;
                _this->_outbuff_ptr++;
            }
        } else {
            int got = _this->_sync->requestData(_this->_sync, _this->_out_samples, std::max(req_samples/_this->_frbits, 1));
            if(got <= 0) { return (got_samples == 0) ? got : got_samples; }
            for(int i = 0; i < got; i++) {
                float lasterr = 10000.0f;
                float minerrval = 0.0f;
                for(int k = 0; k < _this->_frcnt; k++) {
                    float frtarget = _this->_frs[k];
                    float err = frtarget - _this->_out_samples[i]*_this->_syncdiv;
                    if(fabsf(err) < lasterr) {
                        _this->_outbuff[i] = k;
                        lasterr = fabsf(err);
                        minerrval = err;
                    }
                }
                _this->_avgerr += (minerrval - _this->_avgerr) * 0.05f;
//                printf("%d - - - - - - %f\n", x, _this->_frs[_this->_outbuff[i]]/_this->_syncdiv);
//                y++;
            }
            _this->_outbuff_data = got;
            _this->_outbuff_ptr = 0;
        }
    }
    return got_samples;
}


//float tmp[10];
//int tmpidx = 0;

int cdsp_demod_mfsk::dcb_requestData(void* ctx, float* data, int samples_cnt) {
    cdsp_demod_mfsk* _this = (cdsp_demod_mfsk*) ctx;
    if(!_this->_running || _this->_input_func==NULL || _this->_incr <= 0) {return -2;}
    int req_samples = std::min(samples_cnt, CDSP_DEF_BUFF_SIZE);
    // int got = _this->_input_func(_this->_func_call_ctx, _this->_in_samples, req_samples);
    int got = _this->_infilt->requestData(_this->_infilt, _this->_in_samples, req_samples);
    if(got <= 0) {return got;}
    for(int i = 0; i < got; i++) {
        float fr_rel = (_this->_in_samples[i]*_this->_prev_spl.conj()).ph() * (1.0f/(2.0f*FL_PI)); //Interesting f/fs detector, stolen from gnuradio quadrature demod; works SIGNIFICANTLY better than coherent multiplication&filtering
        _this->_prev_spl = _this->_in_samples[i];
        data[i] = fr_rel * _this->_syncmul;

    }
    return got;
}

int cdsp_demod_mfsk::infilt_requestData(void* ctx, cdsp_complex_t* data, int samples_cnt) {
    cdsp_demod_mfsk* _this = (cdsp_demod_mfsk*) ctx;
    if(!_this->_running || _this->_input_func==NULL || _this->_incr <= 0) {return -2;}
    return _this->_input_func(_this->_func_call_ctx, data, samples_cnt);
}


void cdsp_demod_mfsk::_do_start() {
    _outbuff_data = 0;
    _outbuff_ptr = 0;
    _outbuff_bit = 0;
    _avgerr = 0;
    _infilt->start(true);
    _sync->start(true);
}

void cdsp_demod_mfsk::_do_stop() {
    _infilt->stop(true);
    _sync->stop(true);
}


cdsp_demod_msk::cdsp_demod_msk(float fs, float datarate, float sync_loop_bw, float sync_damping, float sync_relLimit) {
    setFs(fs);
    setDataRate(datarate);
    _filt = new cdsp_fir<float, float>(_taps_cnt, _filt_taps);
    _sync = new cdsp_maximum_likelihood_tr<float>(_incr, sync_loop_bw, sync_damping, sync_relLimit);
    _dcblock = new cdsp_dcblock<float>(1.0f);
    _infilt = new cdsp_fir<cdsp_complex_t, cdsp_complex_t>(_infilt_taps_cnt, _infilt_taps);
    _sync->setInputBlk(_dcblock, _dcblock->requestData);
    _dcblock->setInputBlk(_filt, _filt->requestData);
    _filt->setInputFunc(this, dcb_requestData);
    // _sync->setInputFunc(this, dcb_requestData);
    _infilt->setInputFunc(this, infilt_requestData);
}

cdsp_demod_msk::~cdsp_demod_msk() {
    delete _sync;
    delete _filt;
    delete _infilt;
    delete[] _filt_taps;
    delete[] _infilt_taps;
}

void cdsp_demod_msk::setFs(float fs) {
    _fs = fs;
    if(_datarate != 0) {
        _incr = _fs / (_datarate);
        _taps_cnt = (int(roundf(_incr)) % 2) ? roundf(_incr)+1 : roundf(_incr);
        _infilt_taps_cnt = _taps_cnt;
        // _taps_cnt = 1;
        _syncmul = 1.0f/(_datarate/(4.0f*_fs));
//        _syncmul = 1.0f;
        _syncdiv = _datarate/(4.0f*_fs);
        if(_filt_taps != NULL) {
            delete[] _filt_taps;
        }
        if(_infilt_taps != NULL) {
            delete[] _infilt_taps;
        }
        _filt_taps = new float[_taps_cnt];
        _infilt_taps = new cdsp_complex_t[_infilt_taps_cnt];
        cdsp_calc_taps_lpf_float(_filt_taps, _taps_cnt, _fs, _datarate, true);
        int nresp = 33;
        cdsp_complex_t* resp = new cdsp_complex_t[nresp];
        _froffs = (_datarate + 100.0f)/_fs; //Required bc analog circuit works like shit with frequencies < ~100 Hz
        for(int i = 0; i < nresp; i++) {
            float fr = (i - (nresp)/2.0f) / (float)nresp;
            float fr_hz = fr*_fs;
            float mag = 0.0000f;
            if(fr_hz >= 100.0f && fr_hz <= 2*_froffs*_fs+2*_datarate) {
                mag = 1.0f;
            }
            resp[i].i = mag;
            resp[i].q = 0.0f;
        }
        cdsp_calc_taps_complex_fromresp(resp, _infilt_taps, nresp, _infilt_taps_cnt, true);
        if(_filt != NULL) {
            _filt->setTaps(_taps_cnt, _filt_taps);
        }
        if(_infilt != NULL) {
            _infilt->setTaps(_infilt_taps_cnt, _infilt_taps);
        }
        if(_sync != NULL) {
            _sync->setInSps(_incr);
        }
        delete[] resp;
    }
}

void cdsp_demod_msk::setDataRate(float datarate) {
    _datarate = datarate;
    if(_datarate != 0) {
        setFs(_fs);
    }
}

int cdsp_demod_msk::requestData(void* ctx, uint8_t* data, int samples_cnt) {
    cdsp_demod_msk* _this = (cdsp_demod_msk*) ctx;
    if(!_this->_running || _this->_incr <= 0) { return -2;}
    int req_samples = std::min(samples_cnt, CDSP_DEF_BUFF_SIZE);
    int got = _this->_sync->requestData(_this->_sync, _this->_out_samples, req_samples);
    if(got <= 0) { return got; }
    for(int i = 0; i < got; i++) {
         float curr_fr = _this->_out_samples[i] * _this->_syncdiv;
         float err0 = fabsf(-(_this->_datarate/(4.0f*_this->_fs)) - curr_fr);
         float err1 = fabsf((_this->_datarate/(4.0f*_this->_fs)) - curr_fr);
         float minerr = fabsf(err0) > fabsf(err1) ? err1 : err0;
         data[i] = fabsf(err0) > fabsf(err1) ? 1 : 0;
         _this->_avgerr += (minerr - _this->_avgerr) * 0.05f;
//         _this->_avgerr = curr_fr;
    }
    return got;
}

void cdsp_demod_msk::setLoopBw(float bw) {
	_sync->setLoopBw(bw);
}

int cdsp_demod_msk::dcb_requestData(void* ctx, float* data, int samples_cnt) {
    cdsp_demod_msk* _this = (cdsp_demod_msk*) ctx;
    if(!_this->_running || _this->_input_func==NULL || _this->_incr <= 0) {return -2;}
    int req_samples = std::min(samples_cnt, CDSP_DEF_BUFF_SIZE);
    // int got = _this->_input_func(_this->_func_call_ctx, _this->_in_samples, req_samples);
    int got = _this->_infilt->requestData(_this->_infilt, _this->_in_samples, req_samples);
    if(got <= 0) {return got;}
    for(int i = 0; i < got; i++) {
        float fr_rel = ((_this->_in_samples[i]*_this->_prev_spl.conj()).ph() * (1.0f/(2.0f*FL_PI))) - (_this->_froffs); //Interesting f/fs detector, stolen from gnuradio quadrature demod; works SIGNIFICANTLY better than coherent multiplication&filtering
        
        data[i] = fr_rel * _this->_syncmul;
//        if(data[i] >= 1.0f) {
//            data[i] = 1.0f;
//        } else if(data[i] <= -1.0f) {
//            data[i] = -1.0f;
//        }
        // data[i] = fr_rel;
        // cdsp_complex_t gen;
        // gen.i = cosf(_this->_phacc);
        // gen.q = -sinf(_this->_phacc);
        // cdsp_complex_t gen2;
        // gen2.i = cosf(_this->_phacc2);
        // gen2.q = -sinf(_this->_phacc2);
        // _this->_phacc += (2.0f*FL_PI)*_this->_datarate/(4.0f*_this->_fs);
        // _this->_phacc2 += (2.0f*FL_PI)*_this->_datarate/(-4.0f*_this->_fs);
        // cdsp_complex_t sym;
        // float a = (_this->_in_samples[i] * gen).ph();
        // float b = (_this->_in_samples[i] * gen2).ph();
        // _this->_int_buff[_this->_int_buff_ptr] = sym;
        // int buff_sz = (int)roundf(_this->_incr*0.5f);
        // _this->_int_buff_ptr = (_this->_int_buff_ptr+1)%(buff_sz);
        // data[i] = 0;
        // data[i].i = fr_rel;
        // data[i].q = 0;
        // for(int k = 0; k < buff_sz; k++) {
            // data[i] = data[i] + (_this->_int_buff[k] / (float)buff_sz);
        // }
        
//         _this->_filt_buff[_this->_filt_ptr] = fr_rel;
//         _this->_filt_ptr = (_this->_filt_ptr + 1) % _this->_taps_cnt;
//         data[i] = 0;
//         for(int k = 0; k < _this->_taps_cnt; k++) {
//            
//             data[i] += _this->_filt_buff[k] * _this->_filt_taps[k];
//         }
//         data[i] *= _this->_syncmul;
        _this->_prev_spl = _this->_in_samples[i];
    }
    return got;
}

int cdsp_demod_msk::infilt_requestData(void* ctx, cdsp_complex_t* data, int samples_cnt) {
    cdsp_demod_msk* _this = (cdsp_demod_msk*) ctx;
    if(!_this->_running || _this->_input_func==NULL || _this->_incr <= 0) {return -2;}
    return _this->_input_func(_this->_func_call_ctx, data, samples_cnt);
}


void cdsp_demod_msk::_do_start() {
    for(int i = 0; i < CDSP_DEF_BUFF_SIZE; i++) {
        _int_buff[i] = 0.0f;
    }
    _phacc = 0;
    _int_buff_ptr = 0;
    _avgerr = 0;
    _infilt->start(true);
    _sync->start(true);
}

void cdsp_demod_msk::_do_stop() {
    _infilt->stop(true);
    _sync->stop(true);
}
