cropinghigh/CBModem/software/esp32/app/components/customhwlibs_esp32/srcs/chl_i2sanalog.cpp

#include "chl_i2sanalog.h"

chl_i2sanalog::chl_i2sanalog() {
    _chl_i2sanalog_dma_rx_buff = (chl_i2sanalog_type1*)heap_caps_malloc(sizeof(chl_i2sanalog_type1)*DMA_I2SANALOG_RX_LINK_BUFF_CNT*DMA_I2SANALOG_RX_LINKS_NUM, MALLOC_CAP_DMA);
    if(_chl_i2sanalog_dma_rx_buff == NULL) {
        printf("I2S0 DMA ERROR: NOT ENOUGH MEMORY FOR RX BUFFER\r\n");
        return;
    }
    _chl_i2sanalog_dma_inlinks = (lldesc_t*)heap_caps_malloc(sizeof(lldesc_t)*DMA_I2SANALOG_RX_LINKS_NUM, MALLOC_CAP_DMA);
    if(_chl_i2sanalog_dma_inlinks == NULL) {
        printf("I2S0 DMA ERROR: NOT ENOUGH MEMORY FOR RX INPUT LINKS\r\n");
        return;
    }
    _chl_i2sanalog_dma_outlinks = (lldesc_t*)heap_caps_malloc(sizeof(lldesc_t)*2, MALLOC_CAP_DMA);
    if(_chl_i2sanalog_dma_outlinks == NULL) {
        printf("I2S0 DMA ERROR: NOT ENOUGH MEMORY FOR TX OUTPUT LINKS\r\n");
        return;
    }
    _rx_streambuffer_mtx = xSemaphoreCreateMutex();
    if(_rx_streambuffer_mtx == NULL) {
        printf("I2S0 DMA ERROR: NOT ENOUGH MEMORY FOR RX STREAM BUFFER MUTEX\r\n");
        return;
    }
    _tx_links_mtx = xSemaphoreCreateMutex();
    if(_tx_links_mtx == NULL) {
        printf("I2S0 DMA ERROR: NOT ENOUGH MEMORY FOR TX LINKS MUTEX\r\n");
        return;
    }
    _xRxStreamBuffer = xStreamBufferCreate(sizeof(chl_i2sanalog_type1)*DMA_I2SANALOG_RX_STREAM_CNT, sizeof(chl_i2sanalog_type1));
    if(_xRxStreamBuffer == NULL) {
        printf("I2S0 DMA ERROR: NOT ENOUGH MEMORY FOR RX STREAM BUFFER\r\n");
        return;
    }
    periph_module_enable(PERIPH_I2S0_MODULE);
    periph_module_enable(PERIPH_SARADC_MODULE);
    periph_rtc_apll_acquire();
    _reset_module();
    if(esp_intr_alloc(ETS_I2S0_INTR_SOURCE, ESP_INTR_FLAG_IRAM, _i2sanalog_intr_hdlr, this, &_i2sanalog_intr_hdl) != ESP_OK) {
        printf("I2S0 ERROR: ESP INTR ALLOC FAIL\r\n");
        return;
    }
    _tx_links_task_hdl = NULL;
    REG_WRITE(I2S_INT_CLR_REG(0), 0xffffffff);
    clearRxBuffers();
    clearTxBuffers();
    REG_WRITE(I2S_INT_ENA_REG(0), I2SANALOG_INTERRUPTS_ENA);
}

chl_i2sanalog::~chl_i2sanalog() {
    esp_intr_free(_i2sanalog_intr_hdl);
    periph_module_disable(PERIPH_I2S0_MODULE);
    periph_module_disable(PERIPH_SARADC_MODULE);
    heap_caps_free(_chl_i2sanalog_dma_rx_buff);
    heap_caps_free(_chl_i2sanalog_dma_inlinks);
    heap_caps_free(_chl_i2sanalog_dma_outlinks);
    vSemaphoreDelete(_tx_links_mtx);
    vSemaphoreDelete(_rx_streambuffer_mtx);
    vStreamBufferDelete(_xRxStreamBuffer);
    periph_rtc_apll_release();
}

void chl_i2sanalog::configureADC(int ichan, int qchan, int bitwidth, int attenuation) {
    REG_SET_FIELD(SYSCON_SARADC_CTRL_REG, SYSCON_SARADC_SAR1_PATT_LEN, 4-1);
    int bitwidth_field = (bitwidth == 9) ? 0b00 : ((bitwidth == 10) ? 0b01 : ((bitwidth == 11) ? 0b10 : 0b11));
    int atten_field = (attenuation == 0) ? 0b00 : ((attenuation == 3) ? 0b01 : ((attenuation == 6) ? 0b10 : 0b11));
    REG_WRITE(SYSCON_SARADC_SAR1_PATT_TAB1_REG, 
              (ichan << 28) | (bitwidth_field << 26) | (atten_field << 24) |
              (qchan << 20) | (bitwidth_field << 18) | (atten_field << 16) |
              (ichan << 12) | (bitwidth_field << 10) | (atten_field << 8) |
              (qchan << 4) | (bitwidth_field << 2) | (atten_field << 0));
}

int chl_i2sanalog::setSampleRate(int sr) {
    // const int cpufreqdiv2 = rtc_clk_xtal_freq_get() * 1000000 * (4 + I2SANALOG_APLL_MUL2 + I2SANALOG_APLL_MUL1/256 + I2SANALOG_APLL_MUL0/65536) / ((I2SANALOG_APLL_DIV + 2) * 2); //APLL freq
    const int cpufreqdiv2 = 80000000;
    uint8_t final_div_bck = 16; //data width(or it's multiplies), shouldn't be changed
    float final_div_clkm = (float)cpufreqdiv2 / (2.0f*(float)sr*(float)final_div_bck);
    if(final_div_clkm >= 255) {
        final_div_clkm = 255;
    }
    uint8_t final_div_clkm_int = floorf(final_div_clkm);
    float clkm_frac = ((float)final_div_clkm - (float)final_div_clkm_int);
    uint8_t final_div_clkm_num = floorf(clkm_frac * 32.0f);
    float real_fr = (cpufreqdiv2 / ((final_div_clkm_int + (float)final_div_clkm_num/32.0f) * final_div_bck*2.0f));
    REG_SET_FIELD(I2S_CLKM_CONF_REG(0), I2S_CLKM_DIV_NUM, final_div_clkm_int);
    REG_SET_FIELD(I2S_CLKM_CONF_REG(0), I2S_CLKM_DIV_B, final_div_clkm_num);
    REG_SET_FIELD(I2S_SAMPLE_RATE_CONF_REG(0), I2S_RX_BCK_DIV_NUM, final_div_bck/2); //2 channels
    REG_SET_FIELD(I2S_SAMPLE_RATE_CONF_REG(0), I2S_TX_BCK_DIV_NUM, final_div_bck);
    // printf("Inf: %d, Bckdiv: %d, Clkmdiv: %d+%d/32, Fr: %f\n", cpufreqdiv2, final_div_bck, final_div_clkm_int, final_div_clkm_num, real_fr);
    return real_fr;
}

void chl_i2sanalog::startRx() {
    stopRx();
    _chl_i2sanalog_curr_inlink = 0;
    REG_WRITE(I2S_IN_LINK_REG(0), (((uint32_t)&_chl_i2sanalog_dma_inlinks[0]) << I2S_INLINK_ADDR_S) & I2S_INLINK_ADDR_M);
    esp_rom_delay_us(1);
    REG_SET_BIT(I2S_CONF_REG(0), I2S_RX_START);
    REG_SET_BIT(I2S_IN_LINK_REG(0), I2S_INLINK_START);
    _dis_reset = 4;
    // vTaskDelay(50/portTICK_PERIOD_MS); //REQUIRED; moved to data request function
    // REG_CLR_BIT(SYSCON_SARADC_CTRL2_REG, SYSCON_SARADC_MEAS_NUM_LIMIT);
}

void chl_i2sanalog::stopRx() {
    _dis_reset = 0;
    REG_SET_BIT(I2S_IN_LINK_REG(0), I2S_INLINK_STOP);
    REG_CLR_BIT(I2S_CONF_REG(0), I2S_RX_START);
    esp_rom_delay_us(1);
    REG_SET_BIT(SYSCON_SARADC_CTRL2_REG, SYSCON_SARADC_MEAS_NUM_LIMIT);
}

void chl_i2sanalog::startTx() {
    stopTx();
    _chl_i2sanalog_curr_outlink = 0;
    REG_WRITE(I2S_OUT_LINK_REG(0), (((uint32_t)&_chl_i2sanalog_dma_outlinks[0]) << I2S_OUTLINK_ADDR_S) & I2S_OUTLINK_ADDR_M);
    REG_SET_BIT(SENS_SAR_DAC_CTRL1_REG, SENS_DAC_DIG_FORCE);
    esp_rom_delay_us(1);
    REG_SET_BIT(I2S_CONF_REG(0), I2S_TX_START);
    REG_SET_BIT(I2S_OUT_LINK_REG(0), I2S_OUTLINK_START);
}

void chl_i2sanalog::stopTx() {
    REG_SET_BIT(I2S_OUT_LINK_REG(0), I2S_OUTLINK_STOP);
    REG_CLR_BIT(I2S_CONF_REG(0), I2S_TX_START);
    esp_rom_delay_us(1);
    REG_CLR_BIT(SENS_SAR_DAC_CTRL1_REG, SENS_DAC_DIG_FORCE);
}

void chl_i2sanalog::clearRxBuffers() {
    stopRx();
    for(int i = 0; i < DMA_I2SANALOG_RX_LINKS_NUM; i++) {
        _chl_i2sanalog_dma_inlinks[i].eof = 0;
        _chl_i2sanalog_dma_inlinks[i].owner = 1;
        _chl_i2sanalog_dma_inlinks[i].size = (sizeof(chl_i2sanalog_type1)*DMA_I2SANALOG_RX_LINK_BUFF_CNT);
        _chl_i2sanalog_dma_inlinks[i].length = 0;
        _chl_i2sanalog_dma_inlinks[i].buf = (uint8_t*)&_chl_i2sanalog_dma_rx_buff[DMA_I2SANALOG_RX_LINK_BUFF_CNT*i];
        _chl_i2sanalog_dma_inlinks[i].empty = (uint32_t)&_chl_i2sanalog_dma_inlinks[(i + 1) % DMA_I2SANALOG_RX_LINKS_NUM];
    }
    _chl_i2sanalog_curr_inlink = 0;
    REG_SET_BIT(I2S_CONF_REG(0), I2S_RX_FIFO_RESET | I2S_RX_RESET);
    REG_SET_BIT(I2S_LC_CONF_REG(0), I2S_IN_RST);
    esp_rom_delay_us(1);
    REG_CLR_BIT(I2S_CONF_REG(0), I2S_RX_FIFO_RESET | I2S_RX_RESET);
    REG_CLR_BIT(I2S_LC_CONF_REG(0), I2S_IN_RST);
    REG_WRITE(I2S_IN_LINK_REG(0), (((uint32_t)&_chl_i2sanalog_dma_inlinks[0]) << I2S_INLINK_ADDR_S) & I2S_INLINK_ADDR_M);
}

void chl_i2sanalog::clearTxBuffers() {
    stopTx();
    _chl_i2sanalog_dma_outlinks[0].eof = 1;
    _chl_i2sanalog_dma_outlinks[0].owner = 1;
    _chl_i2sanalog_dma_outlinks[0].size = 0;
    _chl_i2sanalog_dma_outlinks[0].length = 0;
    _chl_i2sanalog_dma_outlinks[0].buf = 0;
    _chl_i2sanalog_dma_outlinks[0].empty = (uint32_t)&_chl_i2sanalog_dma_outlinks[1];
    _chl_i2sanalog_dma_outlinks[1].eof = 1;
    _chl_i2sanalog_dma_outlinks[1].owner = 1;
    _chl_i2sanalog_dma_outlinks[1].size = 0;
    _chl_i2sanalog_dma_outlinks[1].length = 0;
    _chl_i2sanalog_dma_outlinks[1].buf = 0;
    _chl_i2sanalog_dma_outlinks[1].empty = (uint32_t)&_chl_i2sanalog_dma_outlinks[0];
    _chl_i2sanalog_curr_outlink = 0;
    REG_SET_BIT(I2S_CONF_REG(0), I2S_TX_FIFO_RESET | I2S_TX_RESET);
    REG_SET_BIT(I2S_LC_CONF_REG(0), I2S_OUT_RST);
    esp_rom_delay_us(1);
    REG_CLR_BIT(I2S_CONF_REG(0), I2S_TX_FIFO_RESET | I2S_TX_RESET);
    REG_CLR_BIT(I2S_LC_CONF_REG(0), I2S_OUT_RST);
    REG_WRITE(I2S_OUT_LINK_REG(0), (((uint32_t)&_chl_i2sanalog_dma_outlinks[0]) << I2S_OUTLINK_ADDR_S) & I2S_OUTLINK_ADDR_M);
}

int chl_i2sanalog::read_samples(chl_i2sanalog_type1* buf, unsigned int count, unsigned int delay) {
    if(xSemaphoreTake(_rx_streambuffer_mtx, delay) != pdTRUE) {
        return -3;
    }
    int rlen = xStreamBufferReceive(_xRxStreamBuffer, buf, count*sizeof(chl_i2sanalog_type1), delay);
    if(rlen > 0 && _dis_reset > 1) {
        _dis_reset--;
    } else if(_dis_reset == 1) {
        REG_CLR_BIT(SYSCON_SARADC_CTRL2_REG, SYSCON_SARADC_MEAS_NUM_LIMIT);
        _dis_reset--;
    }
    xSemaphoreGive(_rx_streambuffer_mtx);
    return (rlen/sizeof(chl_i2sanalog_type1));
}

int chl_i2sanalog::set_tx_buffer(chl_i2sanalog_dact* buf, unsigned int count, unsigned int delay) {
    if(xSemaphoreTake(_tx_links_mtx, delay) != pdTRUE) {
        return -1;
    }
    while(true) {
        if( _chl_i2sanalog_dma_outlinks[0].length == 0) {
            _chl_i2sanalog_dma_outlinks[0].eof = 1;
            _chl_i2sanalog_dma_outlinks[0].owner = 1;
            _chl_i2sanalog_dma_outlinks[0].size = count*sizeof(chl_i2sanalog_dact);
            _chl_i2sanalog_dma_outlinks[0].length = count*sizeof(chl_i2sanalog_dact);
            _chl_i2sanalog_dma_outlinks[0].buf = (uint8_t*)buf;
            if(_chl_i2sanalog_curr_outlink == -1) {
                _chl_i2sanalog_curr_outlink = 0;
                REG_SET_BIT(I2S_OUT_LINK_REG(0), I2S_OUTLINK_START);
            }
            xSemaphoreGive(_tx_links_mtx);
            return 0;
        } else if( _chl_i2sanalog_dma_outlinks[1].length == 0) {
            _chl_i2sanalog_dma_outlinks[1].eof = 1;
            _chl_i2sanalog_dma_outlinks[1].owner = 1;
            _chl_i2sanalog_dma_outlinks[1].size = count*sizeof(chl_i2sanalog_dact);
            _chl_i2sanalog_dma_outlinks[1].length = count*sizeof(chl_i2sanalog_dact);
            _chl_i2sanalog_dma_outlinks[1].buf = (uint8_t*)buf;
            if(_chl_i2sanalog_curr_outlink == -1) {
                _chl_i2sanalog_curr_outlink = 1;
                REG_SET_BIT(I2S_OUT_LINK_REG(0), I2S_OUTLINK_START);
            }
            xSemaphoreGive(_tx_links_mtx);
            return 1;
        } else if(delay != 0) {
            _tx_links_task_hdl = xTaskGetCurrentTaskHandle();
            if(ulTaskNotifyTake(pdTRUE, delay) == pdFALSE) {
                xSemaphoreGive(_tx_links_mtx);
                return -3;
            }
            _tx_links_task_hdl = NULL;
        } else {
            xSemaphoreGive(_tx_links_mtx);
            return -4;
        }
    }
}

int chl_i2sanalog::getRxSamplesCount() {
    return (xStreamBufferBytesAvailable(_xRxStreamBuffer)/sizeof(chl_i2sanalog_type1));
}

void chl_i2sanalog::_reset_module() {
    _dis_reset = 0;
    rtc_clk_apll_enable(true);
    rtc_clk_apll_coeff_set(I2SANALOG_APLL_DIV, I2SANALOG_APLL_MUL0, I2SANALOG_APLL_MUL1, I2SANALOG_APLL_MUL2);
    REG_WRITE(I2S_INT_ENA_REG(0), 0);
    REG_WRITE(I2S_CONF_REG(0), I2S_RX_FIFO_RESET | I2S_TX_FIFO_RESET | I2S_RX_RESET | I2S_TX_RESET);
    esp_rom_delay_us(1);
    REG_WRITE(I2S_CONF_REG(0), I2S_TX_RIGHT_FIRST);
    REG_WRITE(I2S_CONF1_REG(0), I2S_RX_PCM_BYPASS | I2S_TX_PCM_BYPASS);
    REG_WRITE(I2S_CONF2_REG(0), I2S_LCD_EN);
    REG_WRITE(I2S_TIMING_REG(0), 0);
    REG_WRITE(I2S_FIFO_CONF_REG(0), I2S_RX_FIFO_MOD_FORCE_EN | I2S_TX_FIFO_MOD_FORCE_EN | (0x0 << I2S_TX_FIFO_MOD_S) | (0x1 << I2S_RX_FIFO_MOD_S) | (32 << I2S_TX_DATA_NUM_S) | (32 << I2S_RX_DATA_NUM_S));
    REG_WRITE(I2S_CONF_SIGLE_DATA_REG(0), 0);
    REG_WRITE(I2S_CONF_CHAN_REG(0), (0x0 << I2S_TX_CHAN_MOD_S) | (0x1 << I2S_RX_CHAN_MOD_S));
    REG_WRITE(I2S_LC_HUNG_CONF_REG(0), 0);
    REG_WRITE(I2S_CLKM_CONF_REG(0), (1 << I2S_CLKA_ENA_S) | (64 << I2S_CLKM_DIV_NUM_S) | (0 << I2S_CLKM_DIV_B_S) | (32 << I2S_CLKM_DIV_A_S));
    REG_WRITE(I2S_SAMPLE_RATE_CONF_REG(0), (16 << I2S_RX_BITS_MOD_S) | (16 << I2S_TX_BITS_MOD_S) | (25 << I2S_RX_BCK_DIV_NUM_S) | (25 << I2S_TX_BCK_DIV_NUM_S));
    REG_WRITE(I2S_PD_CONF_REG(0), I2S_PLC_MEM_FORCE_PU | I2S_FIFO_FORCE_PU);
    REG_WRITE(I2S_LC_CONF_REG(0), I2S_AHBM_RST | I2S_AHBM_FIFO_RST | I2S_OUT_RST | I2S_IN_RST);
    esp_rom_delay_us(1);
    REG_WRITE(I2S_LC_CONF_REG(0), I2S_OUT_EOF_MODE | I2S_OUT_AUTO_WRBACK);
    REG_WRITE(I2S_RXEOF_NUM_REG(0), DMA_I2SANALOG_RX_LINK_BUFF_CNT/2);
    REG_WRITE(I2S_OUT_LINK_REG(0), (((uint32_t)&_chl_i2sanalog_dma_outlinks[0]) << I2S_OUTLINK_ADDR_S) & I2S_OUTLINK_ADDR_M);
    REG_WRITE(I2S_IN_LINK_REG(0), (((uint32_t)&_chl_i2sanalog_dma_inlinks[0]) << I2S_INLINK_ADDR_S) & I2S_INLINK_ADDR_M);
    REG_WRITE(I2S_PDM_CONF_REG(0), 0);
    REG_WRITE(I2S_PDM_FREQ_CONF_REG(0), 0);

    chl_rtc_gpio_enable_dacs(true, true);

    REG_SET_BIT(SENS_SAR_READ_CTRL_REG, SENS_SAR1_DIG_FORCE | (2 << SENS_SAR1_SAMPLE_CYCLE_S) | (2 << SENS_SAR1_CLK_DIV_S));
    REG_WRITE(SENS_SAR_MEAS_START1_REG, SENS_MEAS1_START_FORCE | SENS_SAR1_EN_PAD_FORCE);
    REG_SET_BIT(SENS_SAR_TOUCH_CTRL1_REG, SENS_XPD_HALL_FORCE | SENS_HALL_PHASE_FORCE);
    REG_SET_FIELD(SENS_SAR_START_FORCE_REG, SENS_SAR2_PWDET_CCT, 4);

    REG_WRITE(SYSCON_SARADC_FSM_REG, (8 << SYSCON_SARADC_RSTB_WAIT_S) | (16 << SYSCON_SARADC_START_WAIT_S) | (100 << SYSCON_SARADC_STANDBY_WAIT_S) | (8 << SYSCON_SARADC_SAMPLE_CYCLE_S));
    REG_WRITE(SYSCON_SARADC_CTRL_REG, SYSCON_SARADC_SAR1_PATT_P_CLEAR | SYSCON_SARADC_SAR2_PATT_P_CLEAR);
    REG_WRITE(SYSCON_SARADC_CTRL_REG, (16 << SYSCON_SARADC_SAR_CLK_DIV_S) | ((2-1) << SYSCON_SARADC_SAR1_PATT_LEN_S) | SYSCON_SARADC_SAR_CLK_GATED | SYSCON_SARADC_DATA_TO_I2S);
    REG_WRITE(SYSCON_SARADC_CTRL2_REG, SYSCON_SARADC_MEAS_NUM_LIMIT | (250 << SYSCON_SARADC_MAX_MEAS_NUM_S) | SYSCON_SARADC_SAR1_INV | SYSCON_SARADC_SAR2_INV);

    // REG_CLR_BIT(SYSCON_SARADC_CTRL2_REG, SYSCON_SARADC_MEAS_NUM_LIMIT); //Doesn't work on ESP32 rev3; moved to start with delay instead

    REG_WRITE(SYSCON_SARADC_SAR1_PATT_TAB1_REG, (0 << 28) | (0b11 << 26) | (0b11 << 24) | (3 << 20) | (0b11 << 18) | (0b11 << 16)); //channel 0,12bit,11dB; channel 3,12bit,11dB

    REG_WRITE(SENS_SAR_DAC_CTRL1_REG, SENS_DAC_CLK_INV);
    REG_WRITE(SENS_SAR_DAC_CTRL2_REG, 0);

    REG_SET_BIT(I2S_FIFO_CONF_REG(0), I2S_DSCR_EN);
}

void chl_i2sanalog::_i2sanalog_intr_hdlr(void* arg) {
    chl_i2sanalog* _this = (chl_i2sanalog*)arg;
    portBASE_TYPE contsw_req = false;
    while(1) {
        uint32_t curr_intr = REG_READ(I2S_INT_RAW_REG(0));
        if((curr_intr & I2SANALOG_INTERRUPTS_RAW) == 0) {
            break;
        }
        REG_WRITE(I2S_INT_CLR_REG(0), curr_intr);
        if(curr_intr & I2S_IN_SUC_EOF_INT_ST) {
            if(_this->_chl_i2sanalog_curr_inlink >= 0) {
                lldesc_t* curr_descr = &_this->_chl_i2sanalog_dma_inlinks[_this->_chl_i2sanalog_curr_inlink];
                _this->_chl_i2sanalog_curr_inlink = (_this->_chl_i2sanalog_curr_inlink + 1) % DMA_I2SANALOG_RX_LINKS_NUM;
                curr_descr->eof = 0;
                curr_descr->owner = 1;
                if(curr_descr->length != 0) {
                    // ets_printf("b %lu eof %u own %u sz %u len %u\r\n", REG_READ(I2S_INLINK_DSCR_REG(0)), curr_descr->eof, curr_descr->owner, curr_descr->size, curr_descr->length);
                    if(xStreamBufferSendFromISR(_this->_xRxStreamBuffer, (const void*)curr_descr->buf, curr_descr->length, &contsw_req) == pdFALSE) {
                        // ets_printf("O");
                    }
                } else {
                    ets_printf("z");
                }
                curr_descr->length = 0;
            } else {
                ets_printf("RXB!\n");
            }
        }
        if((curr_intr & I2S_OUT_DONE_INT_ST)) {
            if(_this->_chl_i2sanalog_curr_outlink >= 0) {
                lldesc_t* curr_descr = &_this->_chl_i2sanalog_dma_outlinks[_this->_chl_i2sanalog_curr_outlink];
                _this->_chl_i2sanalog_curr_outlink = (_this->_chl_i2sanalog_curr_outlink + 1) % 2;
                lldesc_t* next_descr = &_this->_chl_i2sanalog_dma_outlinks[_this->_chl_i2sanalog_curr_outlink];
                if(next_descr->length == 0) {
                    //Not enough data; stopping
                    ets_printf("U");
                    REG_SET_BIT(I2S_OUT_LINK_REG(0), I2S_OUTLINK_STOP);
                    _this->_chl_i2sanalog_curr_outlink = -1;
                }
                curr_descr->eof = 1;
                curr_descr->owner = 1;
                curr_descr->length = 0;
                if(_this->_tx_links_task_hdl != NULL) {
                    vTaskNotifyGiveFromISR(_this->_tx_links_task_hdl, &contsw_req);
                }
            }
        }
    }
    if(contsw_req) {
        portYIELD_FROM_ISR();
    }
}
