cropinghigh/CBModem/(commit log)

2021-06-10 pcb redesign
    [communicator_27mhz.kicad_pcb, communicator_27mhz.sch]
2022-09-02 schematic updates
    [communicator_27mhz.kicad_sch]
2022-09-02 schematic update 2
    [communicator_27mhz.sch]
2022-11-12 partial schematic update
    [communicator_27mhz.kicad_sch]
2022-11-18 another in-progress schematic update
    [communicator_27mhz.kicad_sch]
2022-11-28 another WIP commit
    [communicator_27mhz.kicad_pcb, communicator_27mhz.kicad_sch]
2022-12-03 almost ready sch+pcb
    [communicator_27mhz.kicad_pcb, communicator_27mhz.kicad_sch]
2022-12-03 avoid possible adc overload
    [communicator_27mhz.kicad_pcb, communicator_27mhz.kicad_sch]
2022-12-04 finish PCB v beta2.3, prepare for jlcpcb
    [communicator_27mhz-B_Cu.gbr, communicator_27mhz-B_Mask.gbr, communicator_27mhz-B_Silkscreen.gbr, communicator_27mhz-Edge_Cuts.gbr, communicator_27mhz-F_Cu.gbr, communicator_27mhz-F_Mask.gbr, communicator_27mhz-F_Silkscreen.gbr, communicator_27mhz-NPTH-drl_map.gbr]
2023-02-18 msk mod+demod + adc bugfix
    [cdsp_fir_taps.cpp, cdsp_modulator.cpp, cdsp_modulator.h, cdsp_source.cpp, cdsp_timing_recovery.cpp, cdsp_timing_recovery.h, chl_i2sanalog.cpp]
2023-03-02 basic functions almost done + schematic upd
    [communicator_27mhz.kicad_pcb, communicator_27mhz.kicad_sch]
2024-03-25 fix for single core machines
    [mainwindow.cpp, mainwindow.h]
